Danjovic/Paganini-Clock/README.md

# Paganini-Clock
Wheel of time clock using 16 segment display and a Neopixel LED ring
