Danjovic/Paganini-Clock/doc/boards.png

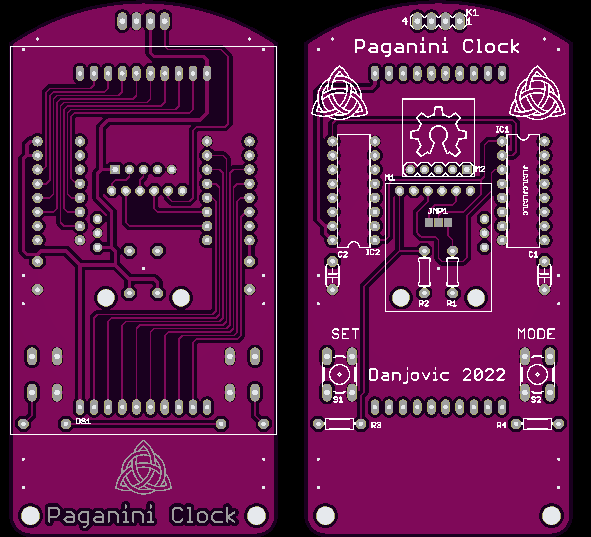
doc/boards.png
