Danjovic/Paganini-Clock/doc/disp16seg-time-18us.png

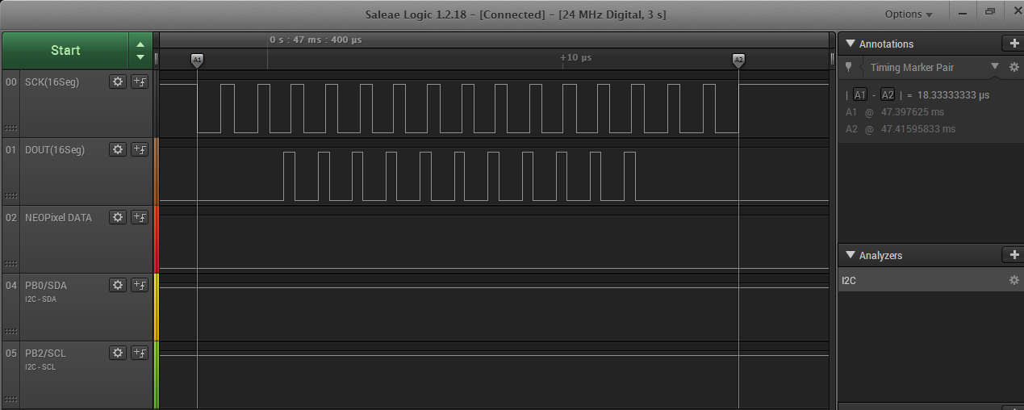
doc/disp16seg-time-18us.png
