Danjovic/Paganini-Clock/doc/full-cycle-10ms.png

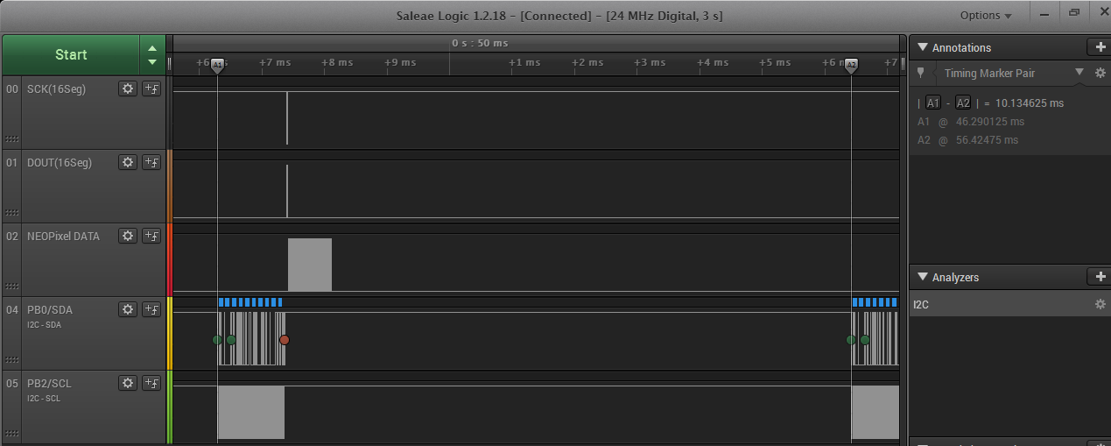
doc/full-cycle-10ms.png
