Danjovic/Paganini-Clock/doc/neopixel-time-695us.png

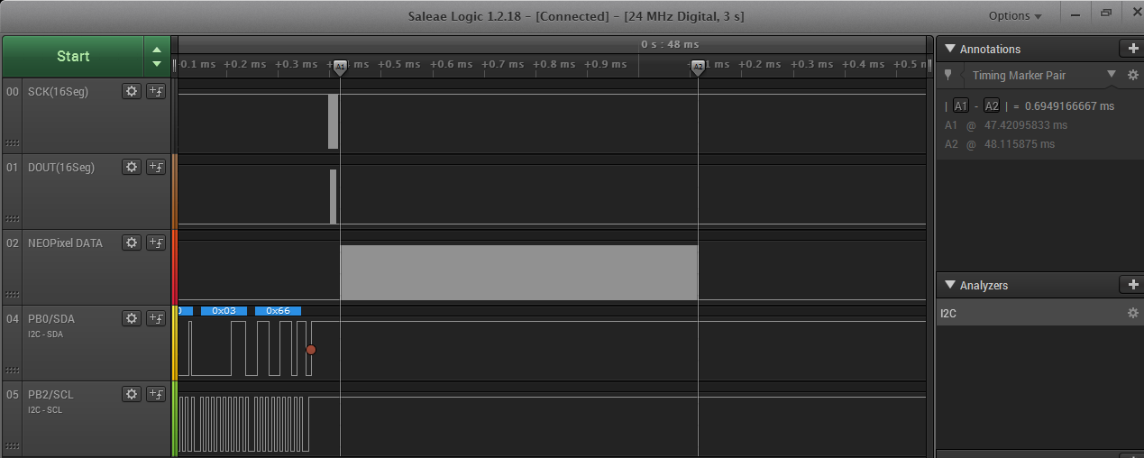
doc/neopixel-time-695us.png
