Danjovic/Paganini-Clock/doc/processing-time-180us.png

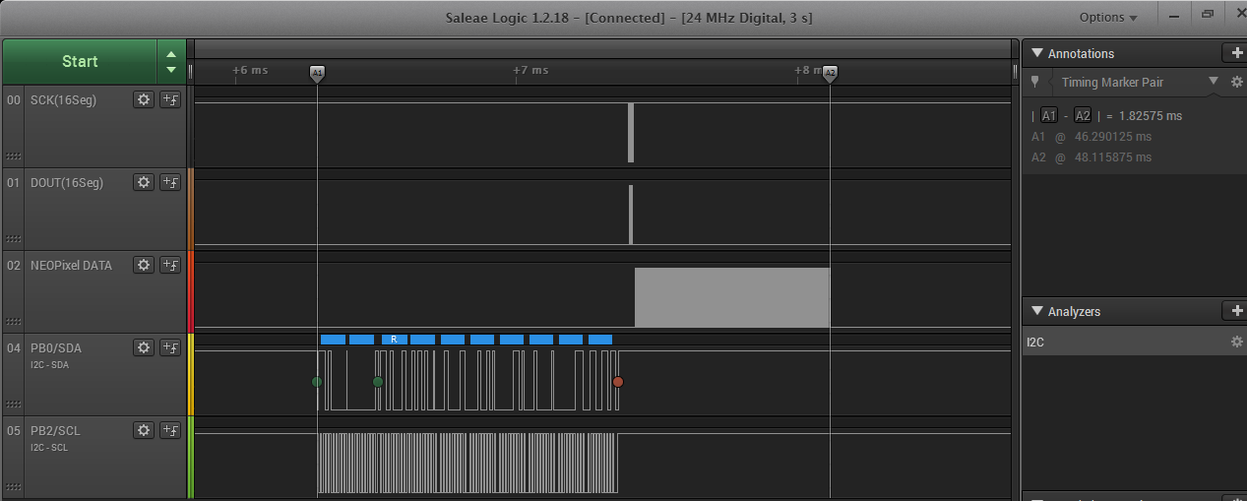
doc/processing-time-180us.png
