Danjovic/Paganini-Clock/doc/statemachine.png

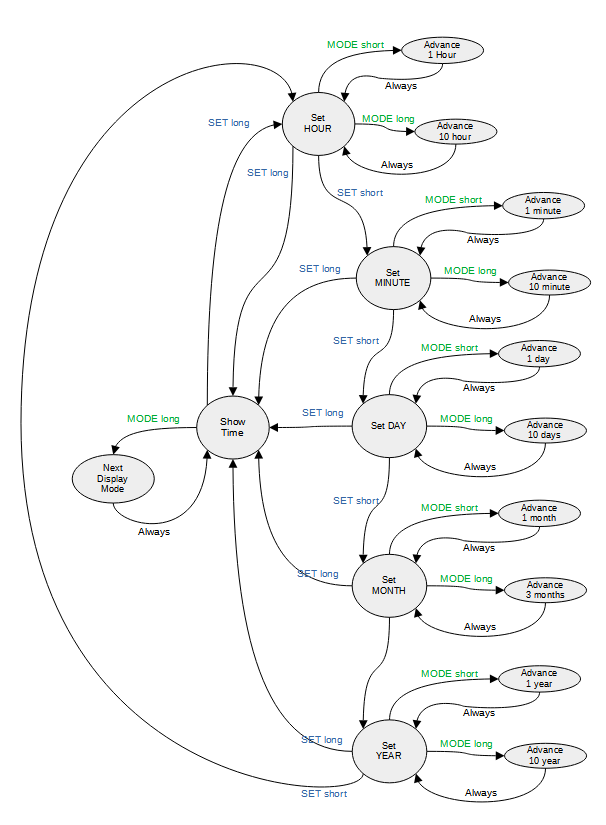
doc/statemachine.png
