Danjovic/Paganini-Clock/doc/waveforms.png

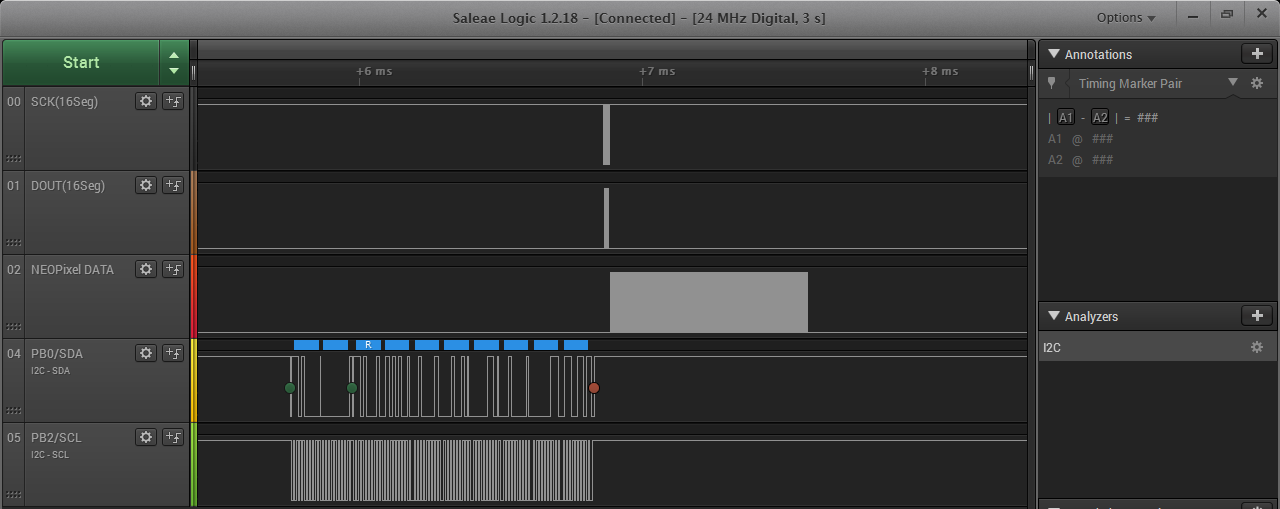
doc/waveforms.png
