Danjovic/Paganini-Clock/doc/wheeloftheyear.jpg

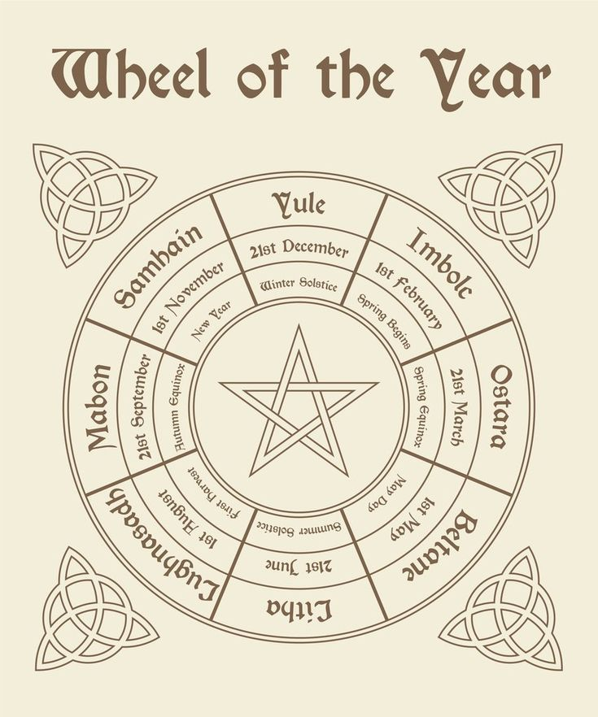
doc/wheeloftheyear.jpg
