Danjovic/Paganini-Clock/doc/PaganiniClock.pdf

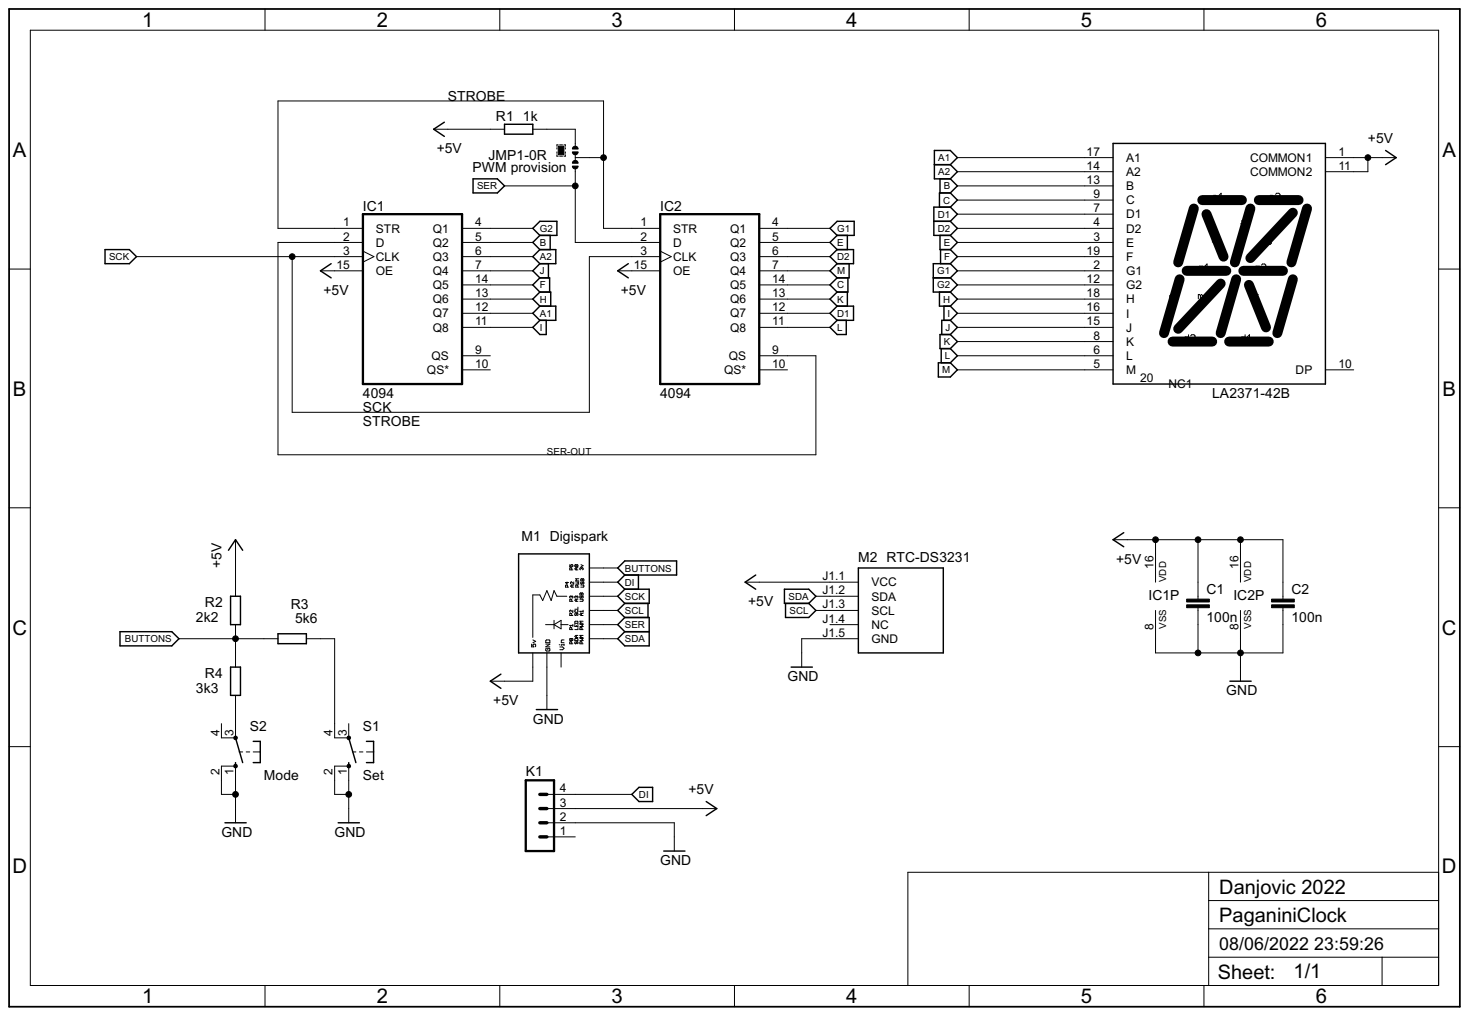
[picture p9: page 1]
