Danjovic/Paganini-Clock/circuit/PaganiniClock.brd

## EAGLE design circuit/PaganiniClock.brd (2022-06-19)

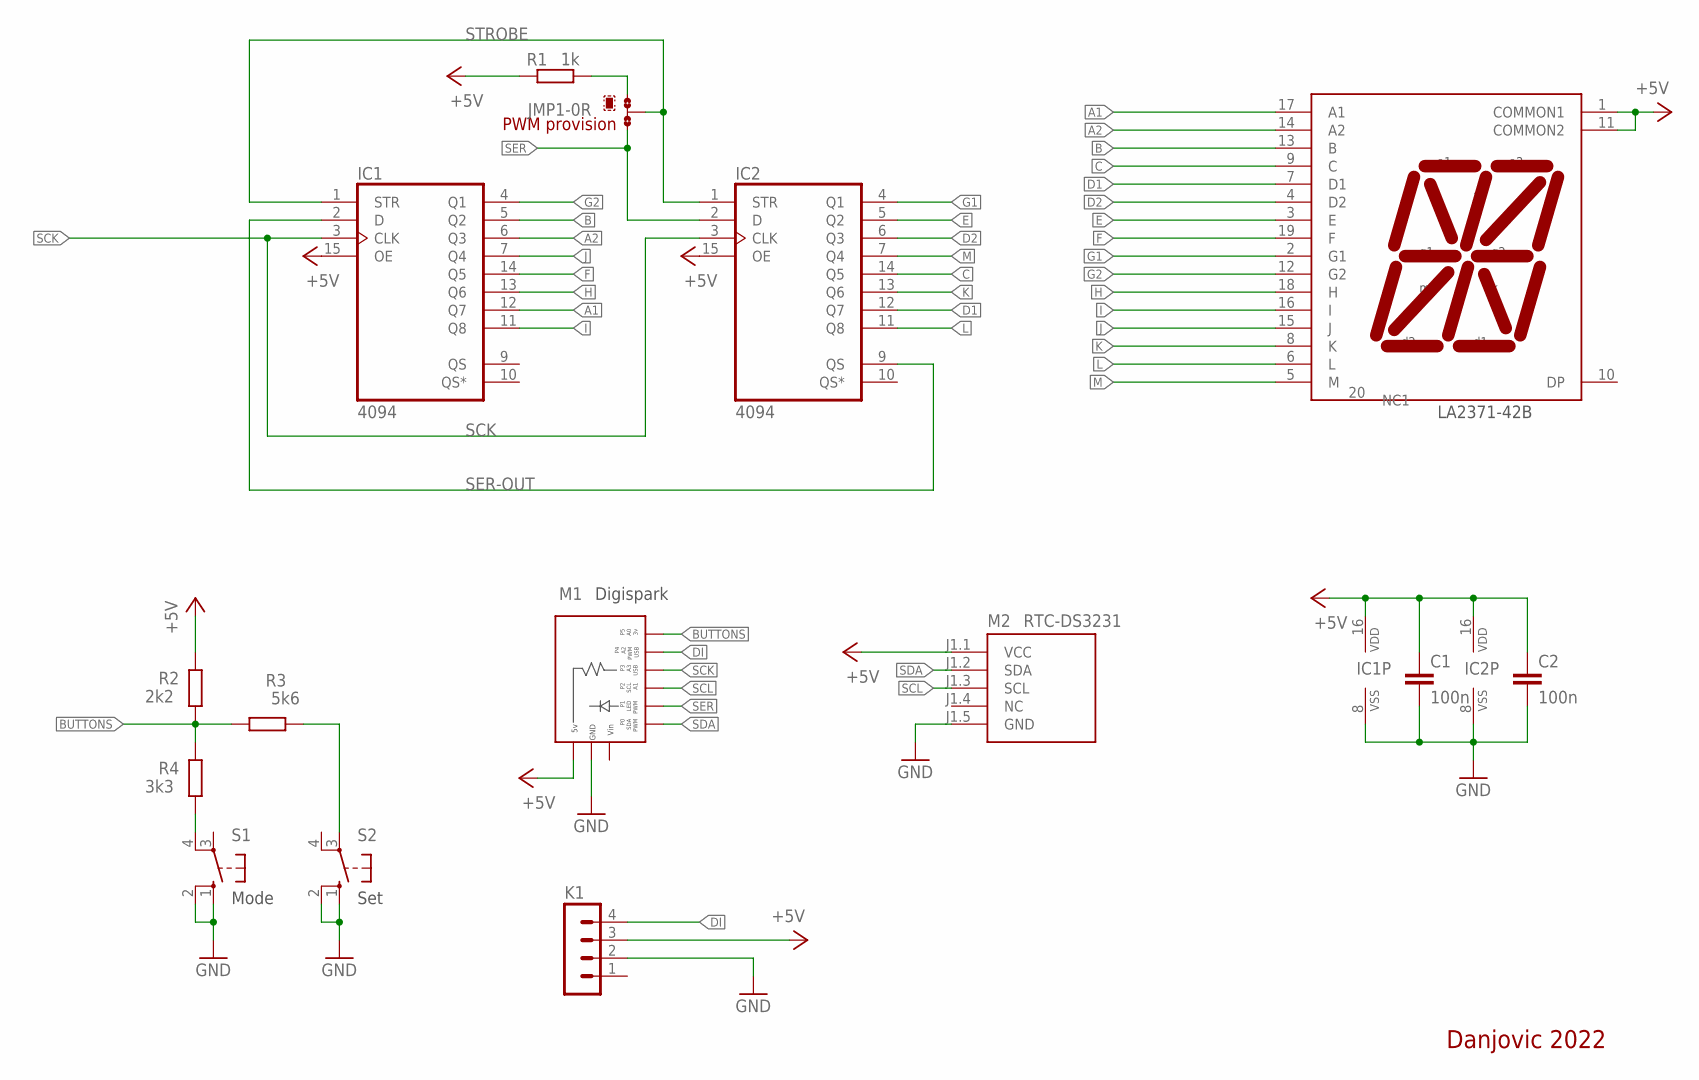
[picture p10: schematic PaganiniClock.sch]

Parts:
C1, C2: 100n; C050-024X044L
DS1: LA2371-42B; LA(C)2371-42B-M1
IC1, IC2: 4094; DIL16R
JMP1: DP_Option; B0R-JMP
K1: MA04-1
M1: Digispark; DIGISPARK_SOCKET
M2: RTC-DS3231; RTC-DS3231_SMALL
R1: 1k; 0204/7L
R2: 2k2; 0204/7L
R3: 5k6; 0204/7L
R4: 3k3; 0204/7L
S1, S2: 10-XX; B3F-10XX

Connections:
+5V: C1.1, C2.1, DS1.1 (COMMON1), DS1.11 (COMMON2), IC1.15 (OE), IC1.16 (VDD), IC2.15 (OE), IC2.16 (VDD), K1.3, M1.5V, M2.J1.1 (VCC), R1.2, R2.2
A1: DS1.17 (A1), IC1.12 (Q7)
A2: DS1.14 (A2), IC1.6 (Q3)
B: DS1.13 (B), IC1.5 (Q2)
BUTTONS: M1.P5, R2.1, R3.2, R4.2
C: DS1.9 (C), IC2.14 (Q5)
D1: DS1.7 (D1), IC2.12 (Q7)
D2: DS1.4 (D2), IC2.6 (Q3)
DI: K1.4, M1.P4
E: DS1.3 (E), IC2.5 (Q2)
F: DS1.19 (F), IC1.14 (Q5)
G1: DS1.2 (G1), IC2.4 (Q1)
G2: DS1.12 (G2), IC1.4 (Q1)
GND: C1.2, C2.2, IC1.8 (VSS), IC2.8 (VSS), K1.2, M1.GND, M2.J1.5 (GND), S1.1 (S), S1.2 (S1), S2.1 (S), S2.2 (S1)
H: DS1.18 (H), IC1.13 (Q6)
I: DS1.16 (I), IC1.11 (Q8)
J: DS1.15 (J), IC1.7 (Q4)
K: DS1.8 (K), IC2.13 (Q6)
L: DS1.6 (L), IC2.11 (Q8)
M: DS1.5 (M), IC2.7 (Q4)
unnamed: JMP1.1, R1.1
unnamed: R3.1, S2.3
unnamed: R4.1, S1.4 (P1)
SCK: IC1.3 (CLK), IC2.3 (CLK), M1.P3
SCL: M1.P2, M2.J1.3 (SCL)
SDA: M1.P0, M2.J1.2 (SDA)
SER: IC2.2 (D), JMP1.3, M1.P1
SER-OUT: IC1.2 (D), IC2.9 (QS)
STROBE: IC1.1 (STR), IC2.1 (STR), JMP1.2
VIN: M1.VIN

Notes on the sheet:
Mode
Set
Digispark
LA2371-42B
Danjovic 2022
PWM provision

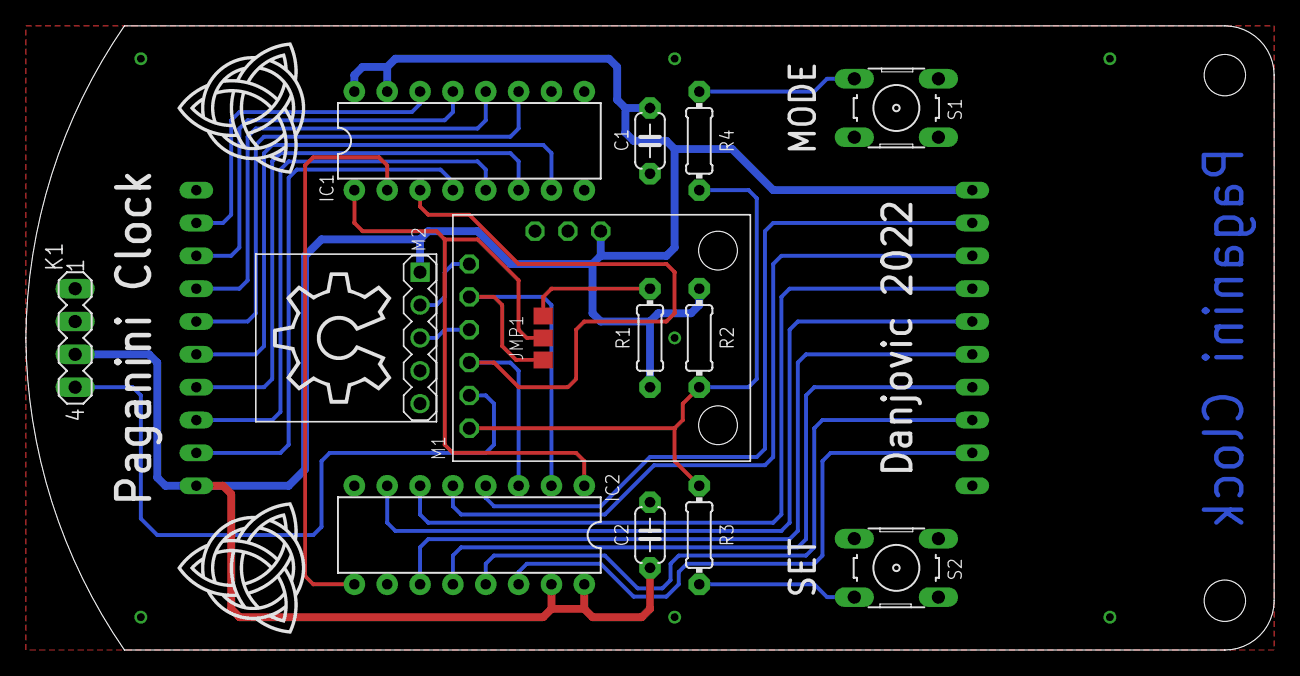
[picture p11: board PaganiniClock.brd from above]

Board: 2 copper layers, 96.5 x 48.3 mm, 15 parts (1 on the bottom side), 29 nets.
